SlugTPU/gf180mcu-slugtpu/kicad/kicad_slugtpu.kicad_pcb

## KiCad design esp-test.kicad_sch

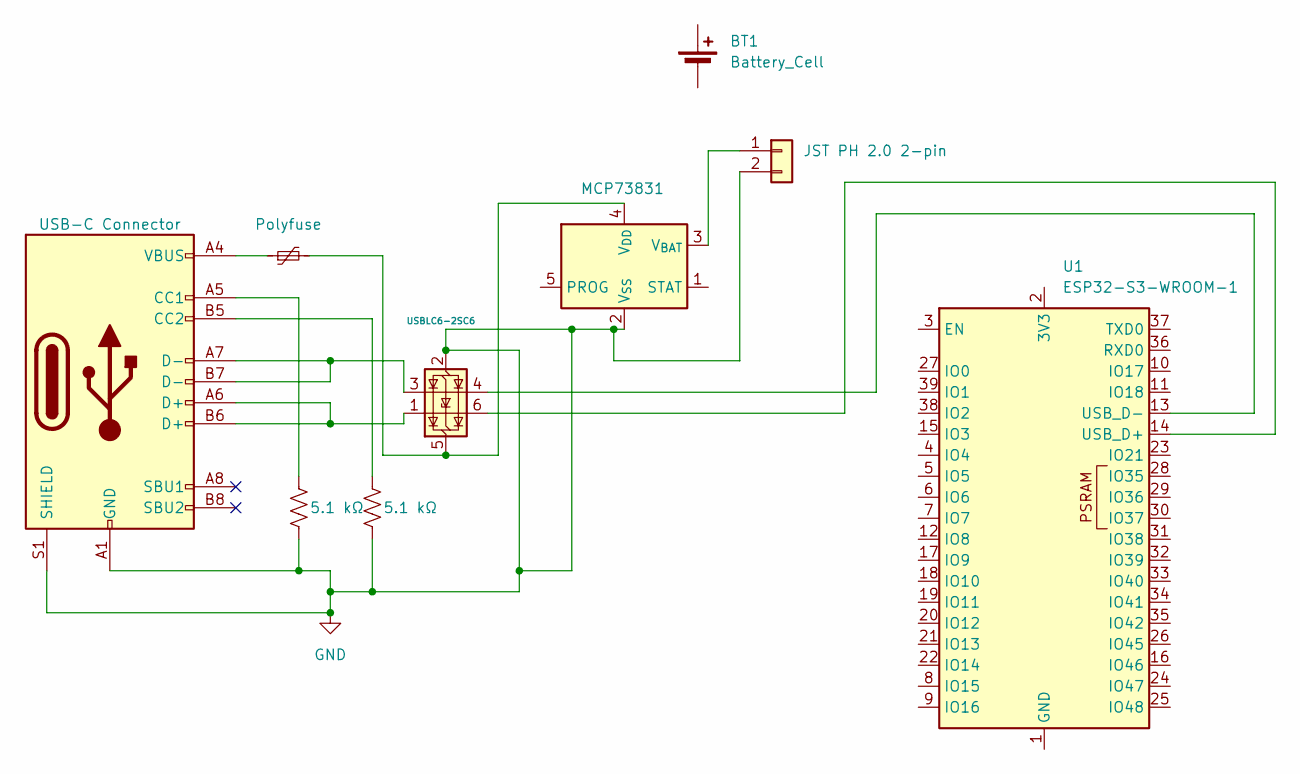
[picture p1: schematic esp-test.kicad_sch]

Parts:
5.1 kΩ: R_US
BT1: Battery_Cell
F1: Polyfuse
JST PH 2.0 2-pin: Conn_01x02
MCP73831: MCP73831-2-OT; SOT-23-5
U1: ESP32-S3-WROOM-1
USB-C Connector: USB_C_Receptacle_USB2.0_16P
USBLC6-2SC6: USBLC6-2SC6; SOT-23-6

Connections:
GND: 5.1 kΩ.2, JST PH 2.0 2-pin.2, MCP73831.2 (V_{SS}), USB-C Connector.A1 (GND), USB-C Connector.A12 (GND), USB-C Connector.B1 (GND), USB-C Connector.B12 (GND), USB-C Connector.S1 (SHIELD), USBLC6-2SC6.2 (GND)
unnamed: 5.1 kΩ.1, USB-C Connector.A5 (CC1), USB-C Connector.B5 (CC2)
unnamed: F1.1, USB-C Connector.A4 (VBUS), USB-C Connector.A9 (VBUS), USB-C Connector.B4 (VBUS), USB-C Connector.B9 (VBUS)
unnamed: F1.2, MCP73831.4 (V_{DD}), USBLC6-2SC6.5 (VBUS)
unnamed: JST PH 2.0 2-pin.1, MCP73831.3 (V_{BAT})
unnamed: U1.1 (GND), U1.40 (GND), U1.41 (GND)
unnamed: U1.13 (USB_D-), USBLC6-2SC6.4 (I/O2)
unnamed: U1.14 (USB_D+), USBLC6-2SC6.6 (I/O1)
unnamed: USB-C Connector.A6 (D+), USB-C Connector.B6 (D+), USBLC6-2SC6.1 (I/O1)
unnamed: USB-C Connector.A7 (D-), USB-C Connector.B7 (D-), USBLC6-2SC6.3 (I/O2)
