SlugTPU/gf180mcu-slugtpu/src/tri_shift.sv

`timescale 1ns/1ps

module tri_shift #(
    parameter int N      = 8,
    parameter int DATA_W = 8
)(
    input  logic                 clk,
    input  logic                 rst,
    input  logic [DATA_W-1:0]    data_i   [N-1:0],
    input  logic                 enable_i,
    output logic [DATA_W-1:0]    data_o   [N-1:0]
);

    genvar lane;
    generate
        for (lane = 0; lane < N; lane++) begin : TRI
            localparam int DEPTH_L = lane + 1;

            logic [DATA_W-1:0] lane_taps [DEPTH_L-1:0];

            shift #(
                .width_p (DATA_W),
                .depth_p (DEPTH_L)
            ) u_shift_lane (
                .clk_i   (clk),
                .reset_i (rst),
                .enable_i(enable_i),
                .data_i  (data_i[lane]),
                .data_o  (lane_taps)
            );

            assign data_o[lane] = lane_taps[DEPTH_L-1];

        end
    endgenerate

endmodule
