SlugTPU/gf180mcu-slugtpu/(commit log)

2026-03-14 Remove basic matmul test and update parameters
    Removed the test for fixed-value matrix-matrix multiplication and adjusted parameterization for tests.
    [test_sysray_nxn.py]
2026-03-14 add open circuit design 3v3 submodule
2026-03-14 Add new simulation test targets for scalar pipe and stage
2026-03-14 Delete cocotb/test_quantizer_mul.py
    No longer reflects current design (m0 is never signed)
2026-03-14 Remove sim-quantizer-mul from README
    This test no longer reflects our current design (m0 is unsigned)
2026-04-07 behavioral wb b4 slave
    This is a flat 4KB array behind a wishbone B4 interface so we can do DRAM verification. In synthesis, when we have a netlist ideally from liteDRAM, we can swap this out with that logic. For now, this should be solid for sim though
    [wb_mem_model.sv]
2026-04-08 cleanup and fix small bug in sram
    [memory_transaction.sv, scalar_stage_sram.sv]
2026-04-09 six tests covering the mux (port isolation, switching, crosstalk, byte sel, etc)
2026-04-09 add kicad project + begin on schematic
    [kicad_slugtpu.kicad_pcb, kicad_slugtpu.kicad_sch]
2026-04-12 update kicad schematic
    [kicad_slugtpu.kicad_sch]
2026-04-14 Update Kicad symbol for esp32
    [kicad_slugtpu.kicad_sch]
2026-04-16 add librelane flow for computing area utilization for mxu
2026-04-16 patch flow
2026-04-16 cocotb still wip, but this is the testing blob of DMA master. wb mux, and memory all together
2026-04-16 spi to wishbone
2026-04-19 multiple tiles work. Workaround for really wierd bug
    [scalar_stage_sram.sv, test_compute_core.py]
2026-04-20 fix issue with some simulators failing to dump outputs due to not properly catching exceptions
    [runner.py]
2026-04-21 Print exception too + ordering
2026-04-21 Remove $fatal on invalid state, as this can trigger right at the start before reset
    [wb_sdr_mt48lc16m16a2_7e.sv]
2026-04-21 Fix accidental delete + typo
    [wb_sdr_mt48lc16m16a2_7e.sv]
2026-04-21 chkpoint: rework auto_refresh to be somewhat based on 'credits'
    [wb_sdr_mt48lc16m16a2_7e.sv]
2026-04-21 Switch to ready hot
2026-04-21 Correct addressing in write
    [wb_sdr_mt48lc16m16a2_7e.sv]
2026-04-21 Fix wait cycles not actually waiting for 100us
    [wb_sdr_mt48lc16m16a2_7e.sv]
2026-04-21 fix incorrect command setting at READ_BEGIN
    [wb_sdr_mt48lc16m16a2_7e.sv]
2026-04-21 Fix prev banks and rows not being set from ACTIVE + fix IDLE->PRECHARGE check
    [wb_sdr_mt48lc16m16a2_7e.sv]
2026-04-22 spi slave (winter 26')
2026-04-23 assign instead of always(@), fixed single sram
    [sram_1x256.sv, sram_8x256.sv]
2026-04-23 b4 pipeline dma checkpoint.
2026-04-27 add more tests + fix bank tracking
    [test_wb_sdr_mt48lc16m16a2_7e.py, wb_sdr_mt48lc16m16a2_7e.sv]
2026-04-30 small fixes to fsm logic
    [spibone_wb.sv]
2026-04-30 fix some potential bugs involving make librelane and setup instantiation for 3v3 srams
    [chip_core.sv, config.yaml]
2026-04-30 Full rework to utilize spibone directly rather than housekeeping
    [spibone_wb.sv, tpu_soc.sv, wb_decoder.sv]
2026-04-30 more tests for wb sdram controller + fix user column addressing
    [test_wb_sdr_mt48lc16m16a2_7e.py, wb_sdr_mt48lc16m16a2_7e.sv]
2026-04-30 Need to add single-word read complete state due to edge case
2026-04-30 Need to add custom spi master for planned implementation
2026-05-01 revert single-read mode; continue using burst mode and fix cs assertions
    [spibone_master.py, spibone_wb.sv, test_tpu_soc_with_dram.py, tpu_regs.sv, tpu_soc.sv]
2026-05-01 substitute casez with case
2026-05-04 maint: add kicad backup files to ignore
2026-05-04 Begin work needed for running librelane flow
2026-05-05 remove .git suffix in submodule to rule out to a potential issue
    [config.yaml]
2026-05-06 fix load pc tb not writing to right address
    [test_tpu_soc_with_dram.py]
2026-05-06 update comment, don't use casez and fix blocking asssignment in always_ff
    [tpu_regs.sv]
2026-05-06 fix: Update corner names
    [config.yaml]
2026-05-07 tested all instructions in control unit, matmul works, bugs with scalar stages
    [control_decoder.sv, mxu.sv, scalar_stage_sram.sv, test_control_decoder.py]
2026-05-07 ai generated assembler rough draft
2026-05-07 dma tests for actual DRAM controller
2026-05-11 Change back VDD and VSS wires from 'inputs' to 'inout'
2026-05-11 move input, output, and word count wires out of tpu_regs; controller should handle these
2026-05-11 Add default value of 0 to s_addr_o in case comb
2026-05-11 clean debug probe
2026-05-11 fix inferred latch due to no default in always_comb of state machine in sdram
    [wb_sdr_mt48lc16m16a2_7e.sv]
2026-05-12 add changes required for running librelane flow
2026-05-12 cleanup spi src directory
2026-05-13 fix non-synthesizable delay bug for combinational input changes
    [sram_1x256.sv, test_control_sram.py, test_control_top.py]
2026-05-13 ready for e2e testing, dma dram access is broken for some reason
    [control_top.sv, test_tpu_soc_with_dram.py, tpu_soc.sv]
2026-05-13 basic data flow test
2026-05-13 fix dma addr increment, sram seems to be broken
    [test_tpu_soc_with_dram.py, wb_dma_master.sv]
2026-05-13 fix compute core test
    [compute_core.sv, control_decoder.sv, mxu.sv, runner.py, sram_1x256.sv, test_compute_core.py, test_tpu_soc_with_dram.py]
2026-05-14 very dumb (but correct) dram fix
    [control_decoder.sv, control_top.sv, test_tpu_soc_with_dram.py, tpu_soc.sv]
2026-05-19 fixed? assembler
2026-05-20 Initial test mode modified slot definitions, which was probably illegal. debug observtion map now behind two new tpu_regs registers accessible over SPI
2026-05-20 fix errors and warnings from verilator
    [spibone_wb.sv]
2026-05-20 fix oscillating WB requests
    [spibone_wb.sv]
2026-05-20 Update spibone dram testbench following reworked spibone module
    [test_spibone_dram.py]
2026-05-20 Bugfix: Fix read not returning an array of results on burst reads
    [spibone_bfm.py]
2026-05-20 Fix issue with counter not being reset on end of word read + fix comment
    [spibone_wb.sv]
2026-05-20 Forgot to update address width when reworking memory model to be word addressed
    [wb_mem_model.sv]
2026-05-20 fix to oscillation loop
    [spibone_wb.sv]
2026-05-20 Cleanup + make explicit this is a write-related issue
    [spibone_wb.sv]
2026-05-20 Cleaner fix to issue with oscillation
    [spibone_wb.sv]
2026-05-20 Rework test_tpu_soc_with_dram to use to SpiboneBFM + more tests
    [test_tpu_soc_with_dram.py]
2026-05-21 add linting via running linting stage in librelane
2026-05-21 move some wires and logic above
2026-05-21 Use logic instead of wire for prodecural assigns
2026-05-23 Refactor for improved variable and wire names that matches current design
2026-05-24 fix: 133MHz clock freq period was reset somewhere in a previous
    [config.yaml]
2026-05-26 Rework pin assignments and macro placements
    [chip_core.sv, config.yaml]
2026-05-26 Fix no EOL lint issue
    [control_buffer.sv, relu_n.sv, sram_1x256.sv, sram_8x256.sv, tri_shift.sv, wb_dma_master.sv]
2026-05-27 update instruction tests with new spi
2026-05-27 many bugs in instruction flow
    [control_decoder.sv, mxu.sv, test_compute_core.py, test_tpu_instructions.py]
2026-05-28 Modify Quantizer Mul to pipeline each stage. Also fix up scalar stage testbenches
    [quantizer_mul.sv, scale_n.sv, test_scalar_pipe.py, test_scalar_stage.py, test_scale_n.py]
2026-05-30 Refactor for SDRAM pin buffering
2026-05-30 Only test with sdram pin buffering so Icarus doesn't take til next year to simulate
    [test_tpu_soc_with_dram.py]
2026-05-30 Cleaner wiring
2026-05-31 Fix stray macro alignment config
    [config.yaml]
2026-05-31 mildly vibecoded general purpose testing framework
2026-06-04 fix pipeline reg width
    [pe.sv]
2026-06-08 Remove extra flip flop for edge detection; directly use synchronizers instead
    [spi_slave.sv]
2026-06-10 Update config with current working flow
2026-06-11 Fix testbench for gate-level testing
    [chip_top_sdram_tb.sv, test_chip_top.py]
2026-06-11 fix lint errors other than constant select
    [tpu_soc.sv, wb_decoder.sv]
2026-06-18 Add Makefile for Tachyon DA CVC sdf
    [Makefile.sdf]
2026-06-18 Forgot to switch to stubs in test tpu workload
2026-06-22 fix main and bigger sram rebase merge
    [sram_1x1024.sv, sram_8x1024.sv, test_tpu_workload.py]
2026-06-23 fix nonsynth generate bug
    [sysray_nxn.sv]
2026-07-11 Use and replace definitions for 1024 SRAMs
    [test_chip_top.py, test_tpu_soc_with_dram.py]
2026-07-11 Update stubs
    [Makefile.sdf]
